MoritzBrauner/paffee/doku/01-kettenglied-57518.md

# Kettenglied LEGO 57518

Teilename bei LDraw: *Technic Chain Tread 5 Wide*. BrickLink: *Technic, Link Tread Wide with 2 Pin
Holes*. Alternative Formnummern: 42479, 88323, 89501. Passendes LEGO-Kettenrad: **57519**,
10 Zähne, Ø 40,4 mm.

Die Maße stammen nicht von Händlerangaben, sondern aus der offiziellen LDraw-Teildatei
(`57518.dat` plus Unterteile `s/57518s01.dat`, `s/57518s02.dat`). Umrechnung: 1 LDU = 0,4 mm.

## Hauptmaße

| Maß | LDU | mm | Fundstelle |
|---|---|---|---|
| Breite gesamt | 96 (±48) | **38,40** | x-Extrema aller Polygone |
| Breite Bodenfläche | 88 (±44) | 35,20 | Fase zwischen y = −14 und −10 |
| Teilung (Gelenkachse → Gelenkachse) | 30 | **12,00** | Gelenkzylinder bei z = 0 und z = −30 |
| Gelenkachse → Bodenfläche | 14 | **5,60** | äußere Deckfläche y = −14 |
| Gelenkachse → innere Lauffläche | 7 | **2,80** | innerste Fläche y = +7 |
| Gliedhöhe gesamt | 21 | 8,40 | |

Verhältnis Breite : Teilung = **3,20 : 1**. Das ist die Kennzahl, an der die Fahrzeugauswahl hängt
(siehe [02](02-massstab-analyse.md)).

Gegenprobe der Teilung über das LEGO-Kettenrad 57519: 10 Zähne, Ø 40,4 mm. Teilkreis für 12 mm
Teilung = 12 / (2·sin 18°) = 38,8 mm, Zahnkopf darüber → passt zu Ø 40,4. Zwei unabhängige
Bestätigungen für 12,00 mm.

## Innenkontur (Laufrollenseite)

Kartiert über x-Bänder, jeweils die innerste Fläche. In LDraw ist −Y oben; die Bodenseite liegt bei
y = −14, die Innenseite bei positivem y.

| Abstand von der Mitte | innerste Fläche | Bedeutung |
|---|---|---|
| 0 … 2,8 mm | y = −5 LDU | **Mittelnut**, 5,6 mm breit, 4,8 mm tief |
| 2,8 … 7,2 mm | y = +7 LDU | **die zwei tragenden Laufbänder**, je ~4,4 mm breit |
| 7,2 … 19,2 mm | y = −6 LDU und tiefer | Außenflansche, 5,2 mm zurückgesetzt — tragen nicht |

Konsequenzen für die Konstruktion:

1. Laufrollen tragen nur auf einem Mittelband von zusammen **9,6 mm** Breite. Breitere Räder bringen
   keine Auflagefläche, weil außen alles 5,2 mm tiefer liegt.
2. Richtige Bauform ist die **Doppelrolle** mit zwei Laufringen bei ±5,0 mm — was der paarigen
   Laufrolle des M24 entspricht.
3. Die Mittelnut nimmt eine **Führungsrippe** an der Rolle auf (≤ 5 mm breit, ~2 mm hoch). Das ist
   die einzige positive Seitenführung, die diese Kette hergibt — ohne sie hält nur das Triebrad die
   Kette in der Spur.

## Material und Verfügbarkeit

ABS, steif; die Beweglichkeit kommt allein aus den Gelenken. Sehr gut verfügbar (Größenordnung
175 000 Stück bei BrickOwl über ~1650 Angebote), Neu-Dunkelgrau ist die häufigste Farbe.
Preis grob 0,25–0,60 € je Glied.
