MoritzBrauner/paffee/doku/03-vorbild-m24-panther.md

# Vorbild: M24 Chaffee als Panther-Attrappe

## Filmhintergrund

- **„Paris brûle-t-il?" / „Is Paris Burning?" (1966, René Clément):** die deutschen Panzer sind
  optisch umgebaute **M24 Chaffee mit aufgeschweißten Blechen**; zusätzlich wurde eine
  Panther-Attrappe eingesetzt. In Modellbauforen taucht dazu ein als **zimmeritierter Panther**
  hergerichteter M24 auf. Primärfotos sind nicht geprüft, Stand: IMFDB + Forenangaben.
- **Abgrenzung:** in „Battle of the Bulge" (1965) waren die deutschen Panzer spanische
  **M47 Patton**, keine M24.
- Der M24 hieß schon im Dienst **„Panther Pup"** — die US Army fürchtete nach der Einführung 1944
  Eigenbeschuss, weil Form und neues Laufwerk auf Distanz dem Panther ähnelten, und legte dafür
  ein eigenes Erkennungs-Schulungsprogramm auf.

Der Umbau ist damit ein dokumentiertes Fahrzeug, kein Fantasieentwurf — und eine Attrappe darf
unmaßstäblich sein.

## M24 Chaffee, Vorbilddaten

Quelle: afvdatabase (Hunnicutt-Tabelle).

| | Wert | 1:10 |
|---|---|---|
| Wannenlänge ohne Rohr, mit Kotflügeln | 5030 mm | 503 mm |
| Rohrüberhang vorn | 530 mm | 53 mm |
| Breite über Kotflügel | 3000 mm | 300 mm |
| Höhe über Fla-MG | 2770 mm | 277 mm |
| Feuerhöhe | 1850 mm | 185 mm |
| Bodenfreiheit | 460 mm | 46 mm |
| Turmdrehkranz | 1500 mm | 150 mm |
| Aufstandslänge | 2851 mm | 285 mm |
| Gefechtsgewicht | 18 400 kg | — |

Laufwerk: 5 paarige Laufrollen, **3 Stützrollen**, Triebrad vorn mit **13 Zähnen**, Leitrad hinten
(Kettenspannung). Drehstabfederung, verwandt mit dem M18 Hellcat.

Ketten:

| Typ | Breite | Teilung | Glieder je Seite |
|---|---|---|---|
| T72, Stahl, Werksausstattung | 406 mm (16″) | 139,7 mm (5,5″) | 75 |
| T85E1, Gummi, Nachkrieg | 356 mm (14″), mit extended end connectors 419 mm | 139,7 mm | 75 |

## Größenvergleich Panther Ausf. G ↔ M24

| | Panther G | M24 | Faktor |
|---|---|---|---|
| Wannenlänge | 6870 mm | 5030 mm | **+37 %** |
| Länge mit Rohr | 8660 mm | 5560 mm | +56 % |
| Breite | 3270 mm (3420 mit Schürzen) | 3000 mm | **+9 % (+14 %)** |
| Höhe | 2990 mm | 2770 mm | **+8 %** |
| Turmdrehkranz | 1650 mm | 1500 mm | **+10 %** |
| Kettenbreite | 660 mm | 406 mm | +63 % |
| Laufrollen je Seite | 8, verschränkt | 5, einzeln | — |
| Gefechtsgewicht | 44 800 kg | 18 400 kg | +143 % |

Der Größenunterschied steckt fast vollständig in **einer** Dimension. Breite, Höhe und sogar der
Turmring liegen fast gleich — ein Panther-Aufbau passt breiten- und höhenmäßig auf einen M24, er
wird nur **zu kurz**. Genau darauf beruhte der Filmumbau.

## Folge für das Modell

Der Maßstab wird vom Fahrwerk gesetzt: **1:10** (ursprünglich 1:11, siehe
[02](02-massstab-analyse.md)). Der Panther-Aufbau wird auf M24-Länge gestaucht — die Wanne hat
die Form des Panthers, aber die Seitenverhältnisse und Maße des Chaffee („pantherfiziert").
Messbar heißt das: die 300 mm Breite entsprechen am echten Panther 1:10,9, die 503 mm Wannenlänge
aber 1:13,7 — das Modell ist ein um ~20 % gestauchter Panther. Das ist kein Fehler, sondern das
Vorbild.

Mit dem Panther-Überhang ragt das Rohr der 7,5 cm KwK 42 L/70 **179 mm** vor den Bug, Gesamtlänge
also ~680 mm; die Rohrlänge ist noch offen, siehe [07](07-wanne.md). Langes Rohr auf kurzer Wanne
ist die Signatur dieser Attrappen.

## Druckteile für die Panther-Optik

Schürzen, Topfblende, Kommandantenkuppel, Bugplatte mit 55°-Neigung, Zimmerit als Textur direkt im
Druck. Die tragende Struktur sind gedruckte Chassis-Längsträger (siehe
[06](06-antrieb-elektronik.md)), die Panther-Teile darüber sind Verkleidung.
