MoritzBrauner/paffee/doku/05-quellen.md

# Quellen

## Kettenglied und LEGO-Teile

- LDraw-Teilebibliothek, `57518.dat` + `s/57518s01.dat` + `s/57518s02.dat` —
  <https://library.ldraw.org/library/official/parts/57518.dat> (Maßgrundlage)
- BrickLink Teil 57518 — <https://www.bricklink.com/v2/catalog/catalogitem.page?P=57518>
- Brick Owl, Large Tread Link (Maßangabe 3,8 cm, Verfügbarkeit) —
  <https://www.brickowl.com/catalog/lego-large-tread-link-57518-88323>
- Rebrickable 57519, 10 Zähne — <https://rebrickable.com/parts/57519/technic-tread-sprocket-wheel-large/>
- Brick Architect 57519 — <https://brickarchitect.com/parts/57519>
- BrickLink 56908, Wheel 43,2 × 26 (Referenzrad für die verworfene Leopard-2-Variante) —
  <https://www.bricklink.com/v2/catalog/catalogitem.page?id=103818&idColor=86>

## M24 Chaffee

- afvdatabase, Light Tank M24 Chaffee — Kettendaten T72/T85E1, 13-Zahn-Triebrad, Aufstandslänge,
  Wannenmaße, Bodenfreiheit, Turmring — <https://afvdatabase.com/usa/m24chaffee.html>
- Tanks Encyclopedia, Stridsvogn M24 — Laufwerksaufbau, 5 Laufrollen / 3 Stützrollen —
  <https://tanks-encyclopedia.com/stridsvogn-m24-m24-chaffee-in-norwegian-service/>
- Key Military, „General Adna's Pup — The M24 Chaffee" — Spitzname „Panther Pup" —
  <https://www.keymilitary.com/article/general-adnas-pup-m24-chaffee>
- M24 Chaffee, Wikipedia — <https://en.wikipedia.org/wiki/M24_Chaffee>
- Friulmodel M24 T85E1 Kettensatz, 170 Glieder (Modellbau-Gegenprobe zur Gliederzahl) —
  <https://spruebrothers.com/fruatl175-1-35-friulmodel-track-link-set-m24-chaffee-t85e1-rubber-type-170-links/>

## Fahrmotor JGB37-520

- Precision Mini Drives, NFP-JGB37-520-EN (Herstellertabelle, Modell 12100: 12 V, 10 000 min⁻¹,
  Zeile 6,25:1 = 1600 min⁻¹, 0,9 kg·cm Blockiermoment, 2,4 A Blockierstrom) —
  <https://precisionminidrives.com/product/37mm-gear-motor-with-encoder-41mm-type-model-nfp-jgb37-520-en>
- rcdrone, JGB37-520 DC Gear Motor (gleiche Tabelle, „nur Referenz"; Anlaufspannung 1,5 V, 144 g) —
  <https://rcdrone.top/products/jgb37-520-dc-gear-motor>
- Micro DC Motors, NFP-JGB37-520-EN (zweite Herstellertabelle, 6,3:1: 1530 min⁻¹, 1,2 kg·cm,
  ≤ 3,5 A; Encoder 11 PPR am Motor) — <https://microdcmotors.com/product/6v-12v-geared-dc-electric-motor-with-encoder-nfp-jgb37-520-en>
- Waveshare UGV02 (gleiche Motorbasis 1:30: Blockierstrom 2,3 A, Leerlaufstrom ≤ 120 mA) —
  <https://www.waveshare.com/wiki/UGV02>

## Filmvorbild

- IMFDB, Is Paris Burning? — M24 als deutsche Panzer, Panther-Attrappe —
  <https://www.imfdb.org/wiki/Is_Paris_Burning%3F>
- Armorama, „Use of Converted/Disguised Tanks in Movies?" — zimmeritierter M24 als Panther —
  <https://archive.armorama.com/forums/193726-page=4.htm>
- IMFDB, Battle of the Bulge — dort M47 Patton als deutsche Panzer (Abgrenzung) —
  <https://www.imfdb.org/wiki/Battle_of_the_Bulge>

## Panther und Vergleichsfahrzeuge

- Panther tank, Wikipedia — Maße, Schachtellaufwerk — <https://en.wikipedia.org/wiki/Panther_tank>
- Tanks Encyclopedia, Panzer V Panther — Turmdrehkranz 1650 mm —
  <https://tanks-encyclopedia.com/ww2/germany/panzer-v_panther.php>
- Das Giesswerk, Reservekettengliedersätze — Kgs-Kettentypen 61/400/120, 63/725/130, 64/660/150 —
  <https://www.giesswerk.de/deutsch/produkte/reservekettenglieders%C3%A4tze/>
- Tank Archives, „Leopard Tracks" — Leopard 1: 550 mm / 160 mm / 84 Glieder, Leopard 2: 635 mm /
  183 mm / 82 Glieder — <https://www.tankarchives.com/2017/05/leopard-tracks.html>
- The Sherman Tank Site, Tracks — Sherman VVSS 16 9/16″ Breite, 6″ Teilung —
  <https://www.theshermantank.com/about/sherman-suspension-and-tracks-the-page-an-easy-to-find-place-for-sherman-suspension-info/tracks-they-are-a-weapon-too/>
- Tanks Encyclopedia, Tiger I — <https://tanks-encyclopedia.com/ww2/germany/panzer-vi_tiger.php>
- Tanks Encyclopedia, Tiger II — <https://tanks-encyclopedia.com/ww2/germany/panzer-vi_konigstiger.php>
- GlobalSecurity, T-72 Design/Mobility — Kettenbreite 0,58 m —
  <https://www.globalsecurity.org/military/world/russia/t-72-design-3.htm>
- T-34, Wikipedia — Kettenbreite 500 mm — <https://en.wikipedia.org/wiki/T-34>

## Nicht belegt / offen

Diese Werte sind Annahmen oder Näherungen und sollten bei Gelegenheit durch Primärquellen ersetzt
werden:

- Laufrollendurchmesser M24 (angenommen 25,5″ = 647,7 mm; aus dem Rollenabstand nur nach oben
  begrenzt: < 713 mm)
- Höhenlage von Trieb- und Leitradmitte am M24
- Kettenteilung von M1 Abrams (T158), T-34 und T-72
- Gewicht eines 57518-Glieds (aus dem Volumen geschätzt)
- Kennwerte des JGB37-520 (Herstellertabellen, nicht am eigenen Motor gemessen; Streuung zwischen
  Herstellern)

Beste erwartbare Quelle für die ersten beiden Punkte: **TM 9-729** oder eine maßhaltige
1:35-Bauanleitung (Bronco, AFV Club, Tamiya).
