MoritzBrauner/paffee/doku/07-wanne.md

# Wanne, Turm und Aufbau

## Stand

Die Wannenform existiert bisher **nur im CAD**. Sie hat die Maße des **M24 Chaffee in 1:10**, das
Laufwerk ist mehr oder weniger vom Chaffee übernommen. Die Form ist „pantherfiziert": die Form
des Panthers, aber mit den Seitenverhältnissen und Maßen des Chaffee.

Der frühere Seitenriss in 1:11 (Zeichnung, Skript und daraus gerechnete Wannenpunkte) ist
verworfen.

## Eckmaße (M24 in 1:10)

| | M24 real | 1:10 |
|---|---|---|
| Wannenlänge mit Kotflügeln | 5030 mm | 503 mm |
| Breite über Kotflügel | 3000 mm | 300 mm |
| Höhe über Fla-MG | 2770 mm | 277 mm |
| Bodenfreiheit | 460 mm | 46 mm |
| Deck-/Turmringebene über Boden | ~1500 mm | ~150 mm |
| Aufstandslänge | 2851 mm | 285 mm |
| Turmdrehkranz | 1500 mm | 150 mm |

Zwischen den Ketten sind es brutto 300 − 2 × 38,4 = ~223 mm; davon gehen die Wannenwände ab. Der
Rest bleibt für die zwei Fahrmotoren (Ø 37 mm, laut Getriebekonzept quer liegend), die beiden
gespiegelten Getriebe, den Schaltservo dazwischen und den Akku. Außen am Bug sitzt je Seite das
Seitenvorgelege (die Getriebewelle durchdringt die Wannenseite); seine Breite geht zwischen
Wannenwand und Kette bzw. Triebrad ab. Der Panther-Turmring (1650 mm) wäre
in 1:10 165 mm; welcher Durchmesser gebaut wird, entscheidet das CAD.

## Grundsatz

Das Fahrwerk gibt die harten Punkte vor (es ist maßstäblich M24), die Panther-Formen werden darüber
gelegt. Wo beides sich widerspricht, gewinnt das Fahrwerk — der Aufbau ist eine Attrappe und darf
unmaßstäblich sein, das Laufwerk nicht.

## Panther-Winkel (Vorbildschnitt Ausf. D/A)

Referenz für die Pantherfizierung. Werte in Klammern gelten für Ausf. G. Die Plattendicken sind
für den Druck irrelevant, stehen aber als Beleg für die Winkelzuordnung. Eine Maßzeichnung mit
Plattenstärken und Winkeln liegt unter
[assets/panther_maße_original.jpg](assets/panther_maße_original.jpg).

| Bauteil | Dicke | Winkel zur Senkrechten |
|---|---|---|
| Glacis | 85 mm (82) | **55°** |
| Bugunterplatte | 65 mm (62) | **55°** — gleicher Winkel, der Bug ist ein Keil |
| Wannenseite oben | 40 mm (50) | **40°** (30°) |
| Wannenseite unten | 40 mm | 0° |
| Heckplatte | 40 mm | **30°**, oben nach hinten geneigt |
| Wannendach | 17 mm | — |
| Wannenboden | 30 mm vorn / 17 mm | — |
| Turmfront | 100 mm | ~7° (83° zur Waagerechten) |
| Blende | 110 mm | rund |
| Turmseite | 45 mm | 25° |
| Turmheck | 45 mm | **28°** |
| Turmdach | 17 mm (30) | — |
| Schürze | 5 mm | 0° |

## Panther-Turm und Rohr, Vorbildmaße

| | Panther real | 1:10 |
|---|---|---|
| Turmhöhe über Deck | 1270 mm | 127 mm |
| Topfblende | Ø 460 mm | Ø 46 mm |
| Kommandantenkuppel, hinten links auf dem Dach | Ø 500 mm | Ø 50 mm |
| Rohrdurchmesser | 130 mm | 13 mm |
| Rohrachse | ~45 % der Turmhöhe über dem Ring | — |
| Mündungsbremse | ~240 × 200 mm (aus dem 1:11-Entwurf zurückgerechnet) | ~24 × 20 mm |

## Rohr — offene Entscheidung

| Variante | Länge vor dem Bug bzw. Rohrlänge | Begründung |
|---|---|---|
| Panther-Überhang | 179 mm vor dem Bug, Gesamtlänge ~680 mm | Überhang 1790 mm (8,66 m Gesamt − 6,87 m Wanne) in 1:10 |
| maßstabsrichtige Rohrlänge | Mündung bis Turmachse 519 mm; bei Turmachse in Wannenmitte ~268 mm vor dem Bug, Gesamtlänge ~770 mm | Mündung–Turmachse am Panther ~5,19 m in 1:10 |

Die zweite Variante ist die geometrisch saubere (das Rohr schrumpft nicht mit der Wanne), die
erste sieht nach Filmfahrzeug aus. Die Turmachsposition am Panther (~50 % der Wannenlänge), auf
der die zweite Variante beruht, ist geschätzt.

## Offene Punkte

- Rohrlänge (siehe oben); maßgeblich ist die Turmposition im CAD
- Draufsicht und Packung: Fahrmotoren, zwei gespiegelte Getriebe mit Servo dazwischen,
  Akkuschacht, Elektronik, Schleifring
- Getriebegehäuse im Querschnitt (zwei gespiegelte Getriebe, Servo, Gestänge) und die
  außenliegenden Seitenvorgelege am Bug
- **Leitrad ↔ Heckplatte:** Das M24-Laufwerk braucht hinten mehr Länge, als eine 30°-Panther-
  Heckplatte hergibt; das Leitrad steht dann hinter der Heckplatte und ragt unter der Schürze
  heraus (am echten M24 ebenso, insofern chassistreu; die Leitradschwinge muss ohnehin nach hinten
  heraus). Im CAD prüfen. Alternativen: Heckplatte flacher (weniger Panther), Laufwerk nach vorn
  schieben, Schürze bis ans Heck ziehen.
- Seitenneigung 40° (Ausf. G: 30°) frisst Deckbreite — mit dem Turmring im CAD abgleichen
- Schürzenlänge und -teilung; Unterkante Schürze über der Kettenoberkante (Gelenkachslinie
  Obertrum + 5,6 mm) mit einigen mm Luft
- Fahrerluken, Sehschlitz, Kugelblende, Werkzeugauflagen
