MoritzBrauner/paffee/doku/assets/panther_maße_formular.pdf

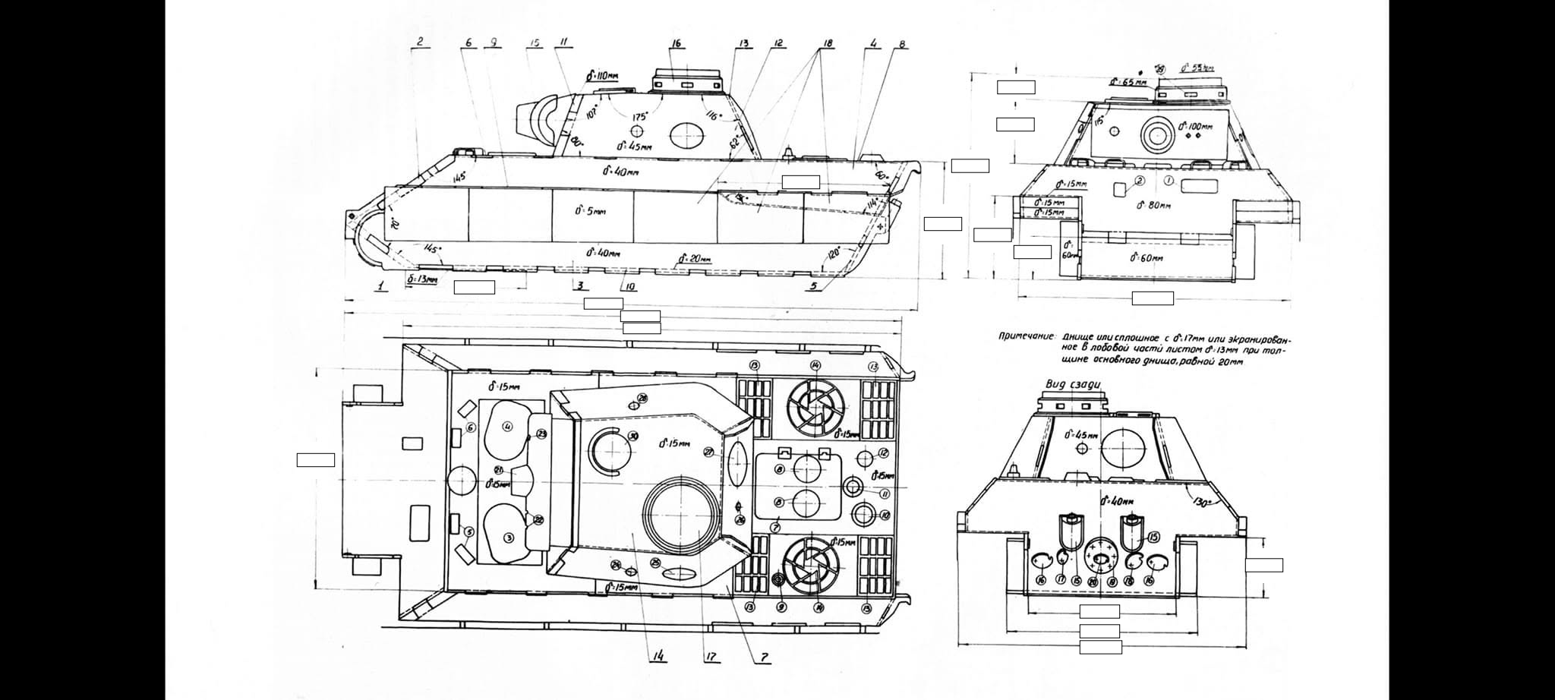
[picture p3: page 1]
