MoritzBrauner/paffee/cad/dog_ring.step

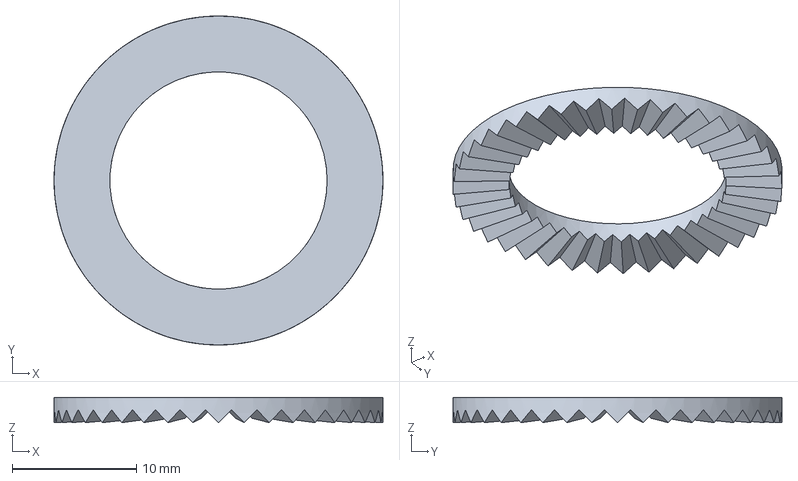
[picture p4: CAD file, 2026-10-31]
cad/dog_ring.step
26.5 x 26.5 x 2.04 mm
