MoritzBrauner/paffee/cad/gear_cutter.step

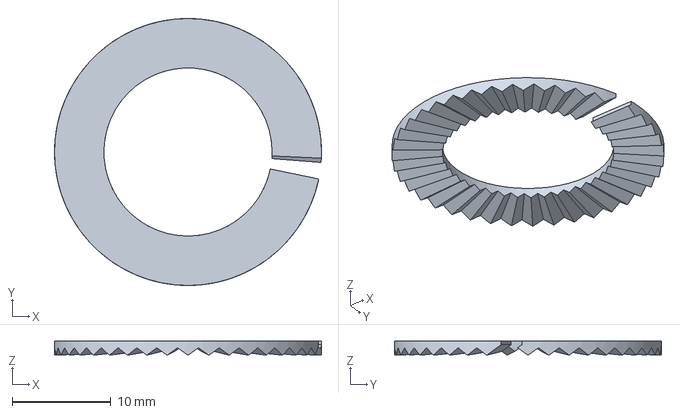
[picture p5: CAD file, 2026-10-31]
cad/gear_cutter.step
27.0 x 27.0 x 1.46 mm
