MoritzBrauner/paffee/(commit log)

2026-09-10 Interrupt rework
2026-09-14 added servo test run
2026-09-14 changed output-pin
2026-09-20 included Timer lib
2026-09-20 added functionality to Timer-Lib
2026-09-21 added pause option to timer
2026-10-08 .idea/ nicht mehr tracken
    CLion erzeugt .idea/ aus platformio.ini jederzeit neu, und editor.xml
    aendert sich mit jeder IDE-Version. Die Dateien bleiben lokal liegen.
2026-10-09 Projektdoku aus rc-tank-panther-m24 übernommen
    Doku nach doku/ migriert und auf den aktuellen Stand gebracht:
    - Maßstab 1:10, die 1:11-Rechnungen (Laufwerk, Gliederzahl,
    Bauschablone) als veraltet markiert
    - Getriebe: Gänge 13:47 / 28:32 mit Reibkupplungen, Seitenvorgelege
    13:47 außen am Bug, ein Servo schaltet beide gespiegelten Getriebe
    - Motordaten JGB37-520 aus Herstellertabellen; antrieb.py und das
    Getriebe-Konzeptblatt auf 1:10 und den 3S-Akku umgerechnet
    - Wannen-Seitenriss (1:11) entfernt, 07-wanne.md auf Stand CAD gekürzt
    .gitignore um Python-Caches, .DS_Store und Druck-Artefakte ergänzt.
    [antrieb.py, getriebe_svg.py, kettenglied_analyse.py, laufwerk.py, laufwerk_svg.py]
2026-10-09 changed Timer lib to use micros instead of millis
2026-10-11 multiple fixes: added default-values for gears, added constructor, started to implement init()-functions
2026-10-12 added Config-Constants for Motor-Channels in main
2026-10-12 fixes, major changes: changed calibration and rpm-getting while calibrating
2026-10-12 Doku: Entscheidung zur Servo-Aufloesung (10 Bit) festgehalten
2026-10-12 Erweiterung der Kalibrierungslogik und Hinzufügen von Toleranzprüfungen für die Drehzahl
2026-10-13 Doku: Sound gestrichen (wird nicht gebraucht)
    Gewicht und Strombudget bleiben als Reserve fuer die Elektronik unveraendert.
2026-10-13 Doku: vorlaeufige ESP32-Pinbelegung eingetragen
    Annahmen: 38-Pin-DevKitC, Turm direkt am Haupt-ESP ohne AS5600, BB-Einheit
    mit Mikroschalter. Turmarchitektur und PCB als offene Punkte vermerkt.
2026-10-13 Testprogramm fuer Kalibrierung und Rev-Match
    Kalibriert den Motor, regelt per Vorsteuerung auf die Drehzahl des am
    Gang-Schalter gewaehlten Zielgangs und misst die Zeit bis +-20 rpm.
    Ausgabe alle 100 ms als CSV. Alle Signale nebeneinander auf der linken
    Stiftleiste (32, 33, 25, 26, 27, 14).
2026-10-14 added pwm and direction test + env
2026-10-14 implemented pwm test
2026-10-14 learning: HIGH on the direction pin means backward
2026-10-14 calibration_test: improved logging
2026-10-15 added file and env for Drivetrain test
2026-10-18 started implementing drivetrain test
2026-10-19 pin-layout v2
2026-10-19 safety: write ledc pin in shiftEngine low for safety
2026-10-19 doku: Pinbelegung mit Getriebe-Fuenferbloecken
    Linke Leiste: Akku, je Getriebe Encoder A/B, Lichtschranke, DIR, PWM
    am Stueck, unten der Schaltservo. Rechts BB, Hoehenservo, nRF24 und
    Turm in Bloecken. PWM rechts auf GPIO12, damit der Pull-down zugleich
    den Strapping-Pin haelt.
    Dazu: Messungen vor dem Verdrahten (MDD10A-Eingang, Modul-Pull-ups),
    Firmware-Folgen (ledcWrite vor ledcAttachPin nach CPU-Reset, nRF-IRQ
    als Pegel wegen Errata GPIO-3.14, SPI.begin mit Pins, ENN-Reihenfolge),
    GPIO-Uebersicht zu 12/14 korrigiert. include/pins.h mit der finalen
    Belegung.
2026-10-19 removed pin declarations from test -> sind jetzt in pins.h
2026-10-20 changed Test to use final pin declarations
2026-10-20 calibration and revmatch test uses pins.h
2026-10-20 added shift-threshold, changed required Rpms, Changed calibration behavior
2026-10-31 added gear cutter and gear teeth for clutches in transmission
